MorrisMA/Chameleon/HW/1033-1004_Chameleon-PCBrA.pdf

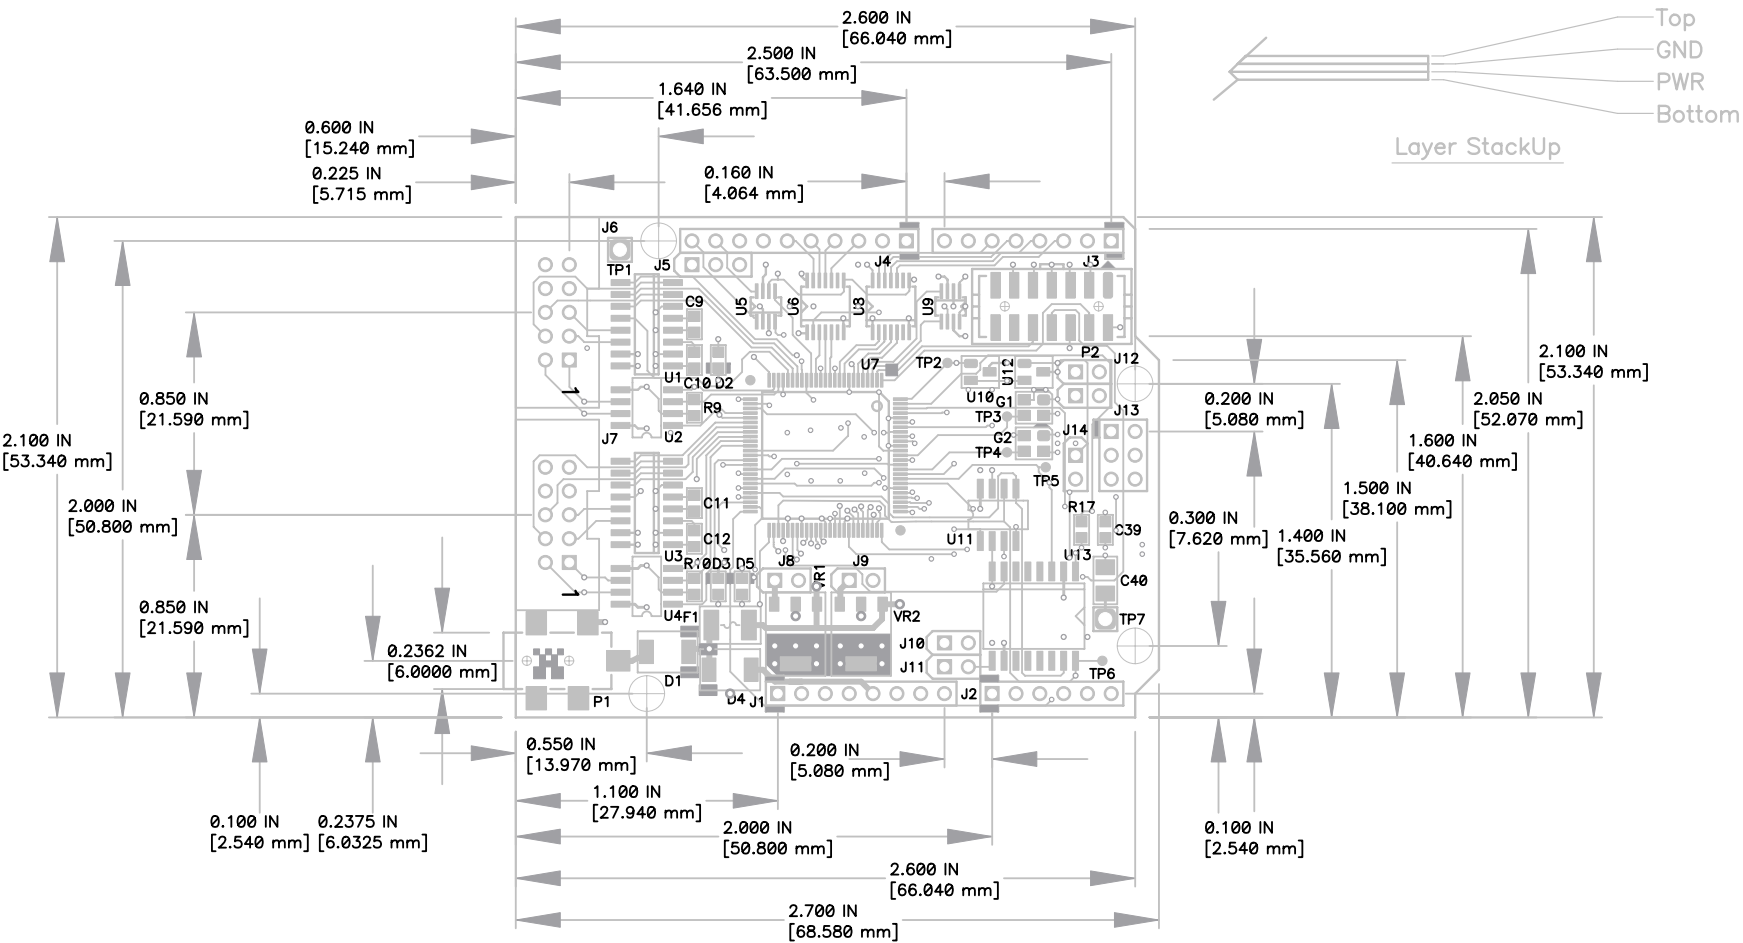
[picture p1: page 1]

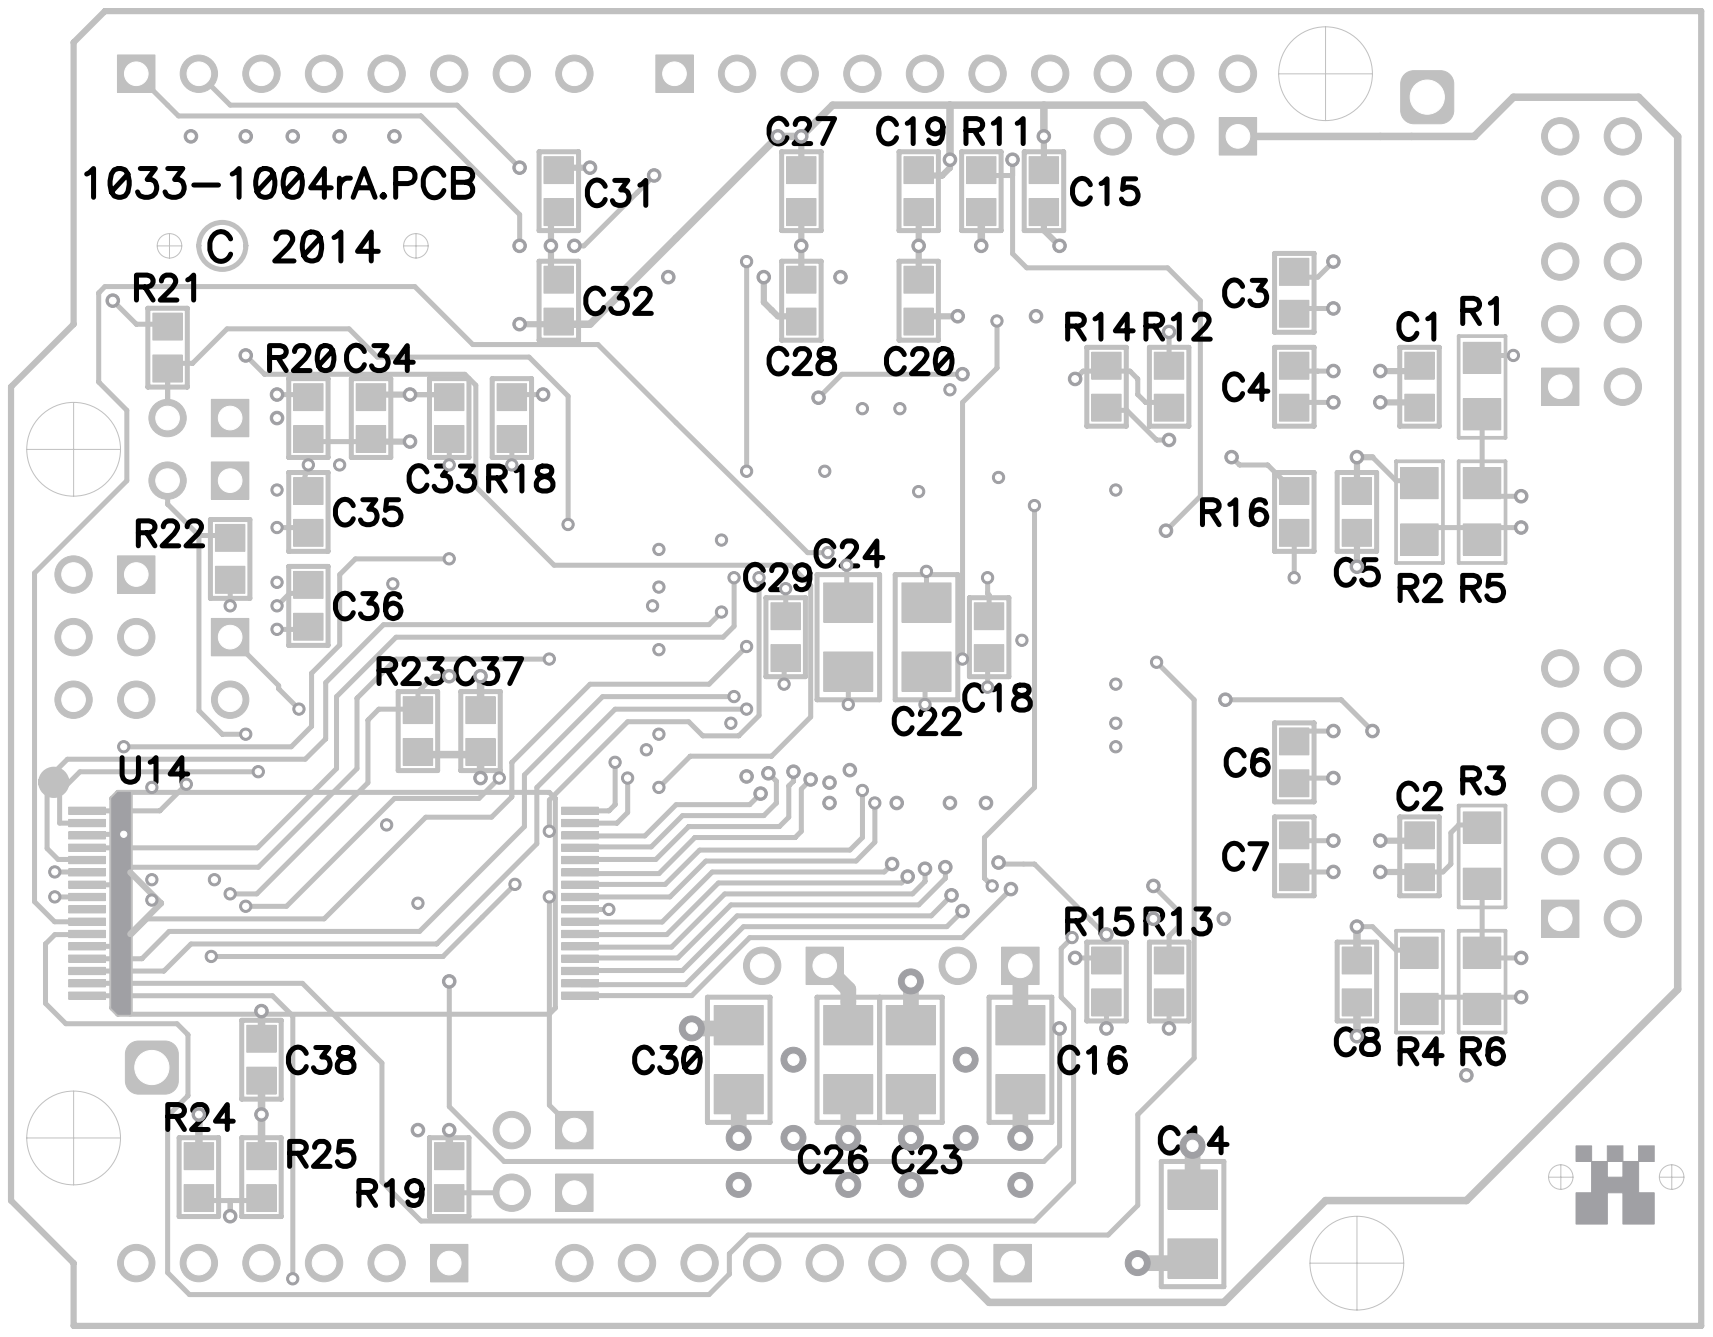
[picture p2: page 2]
