MorrisMA/Chameleon/HW/1033-1004_Chameleon-SCHrA.pdf

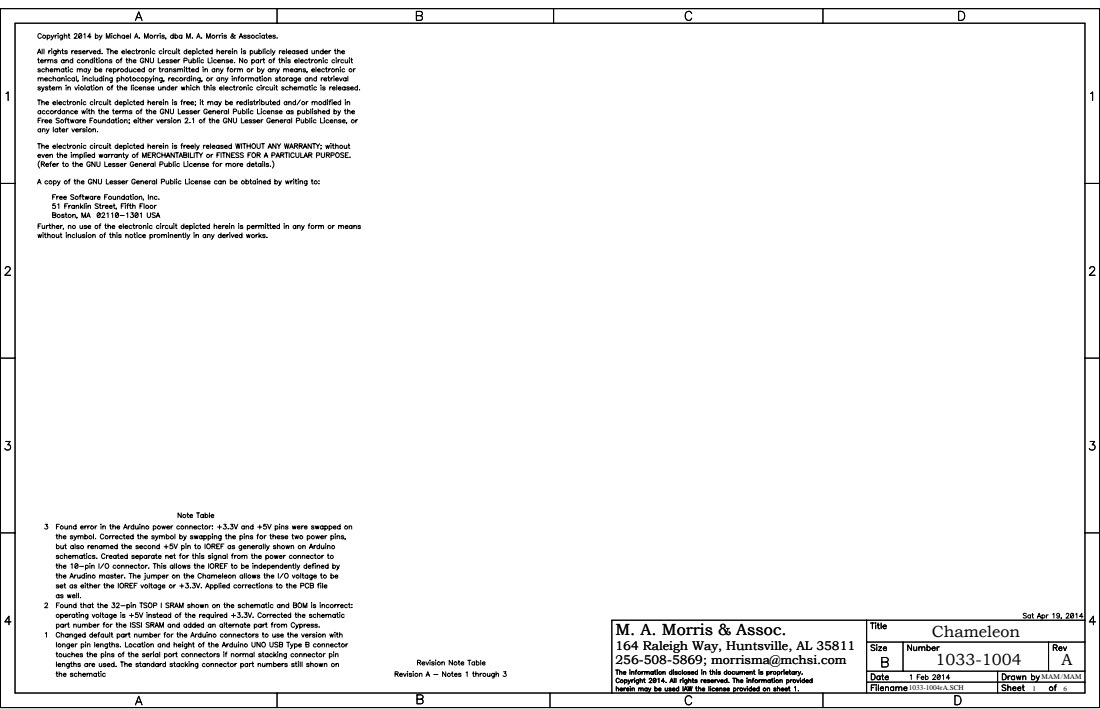
[picture p3: page 1]
MAM; 1033-1004rA.SCH; Chameleon

M. A. Morris & Assoc.
164 Raleigh Way, Huntsville, AL 35811
256-508-5869; morrisma@mchsi.com

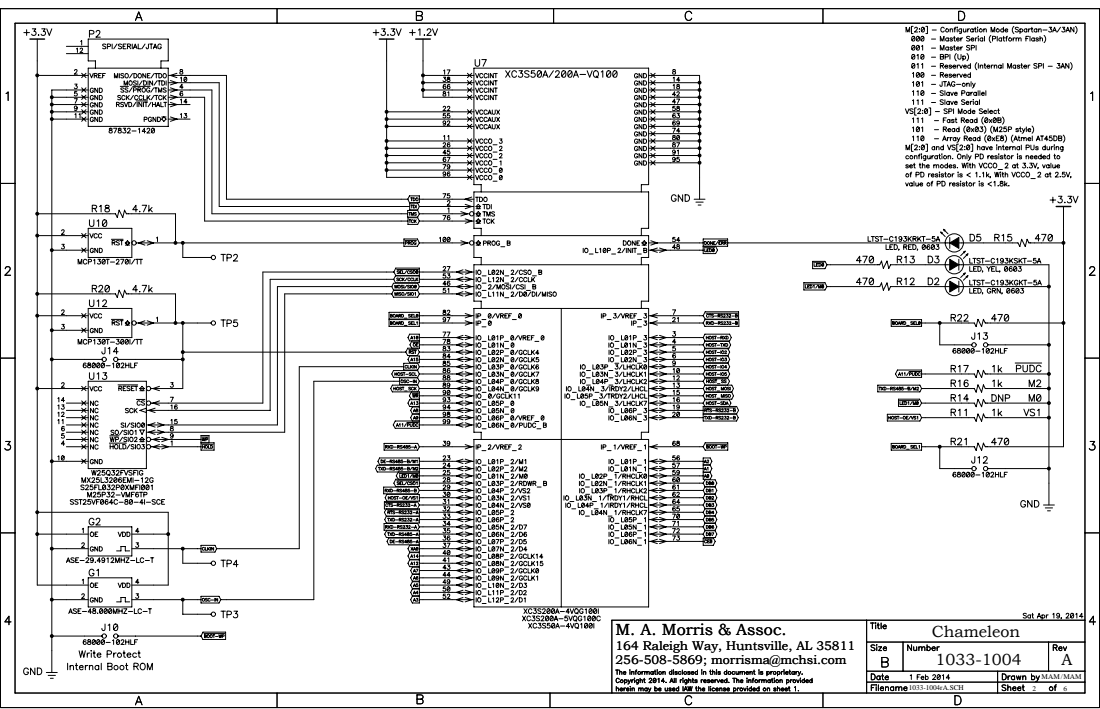
[picture p4: page 2]
Chameleon

M. A. Morris & Assoc.
164 Raleigh Way, Huntsville, AL 35811

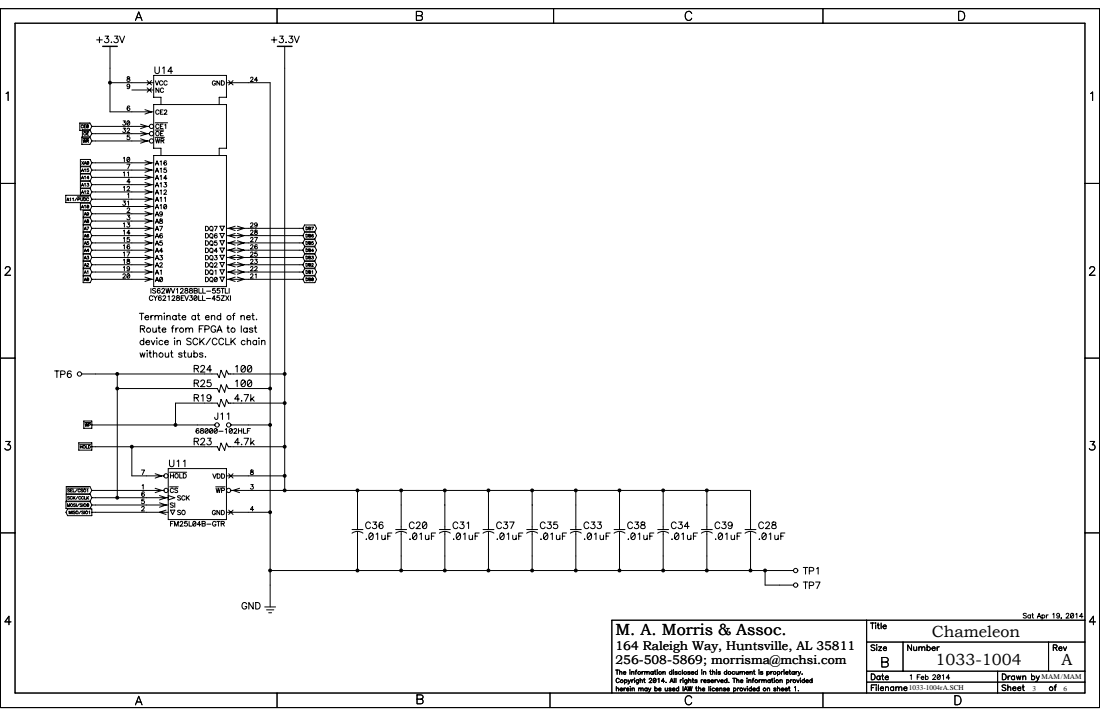
[picture p5: page 3]
Chameleon

M. A. Morris & Assoc.
164 Raleigh Way, Huntsville, AL 35811

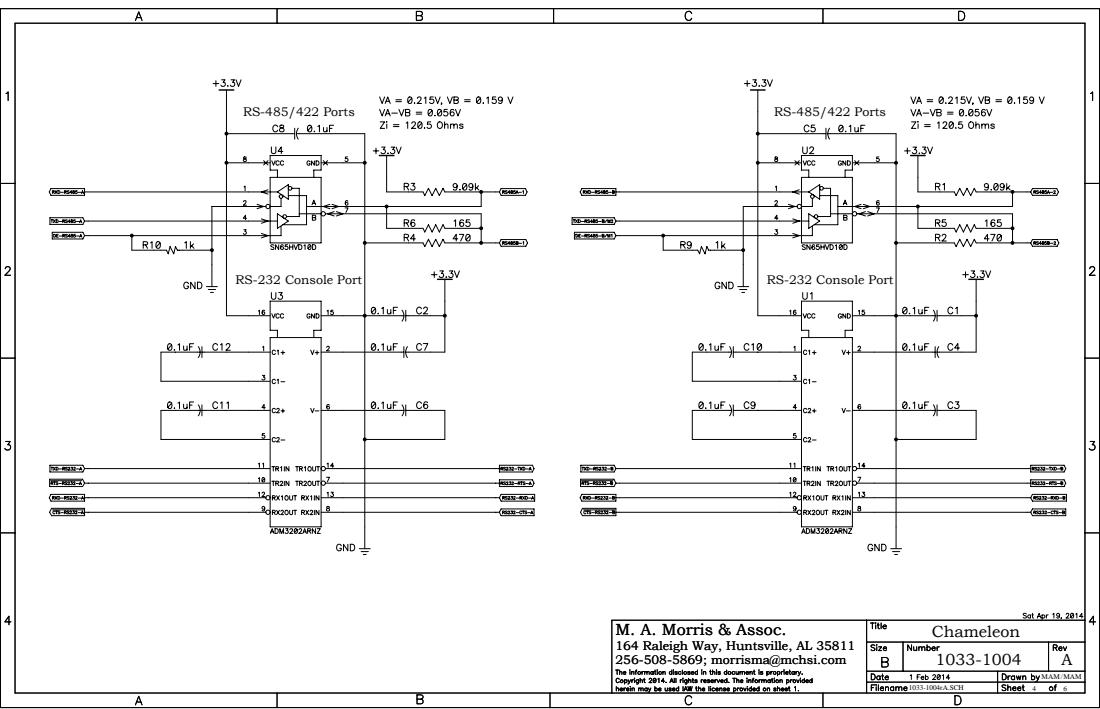
[picture p6: page 4]
RS-485/422 Ports; Chameleon

RS-232 Console Port

M. A. Morris & Assoc.
164 Raleigh Way, Huntsville, AL 35811

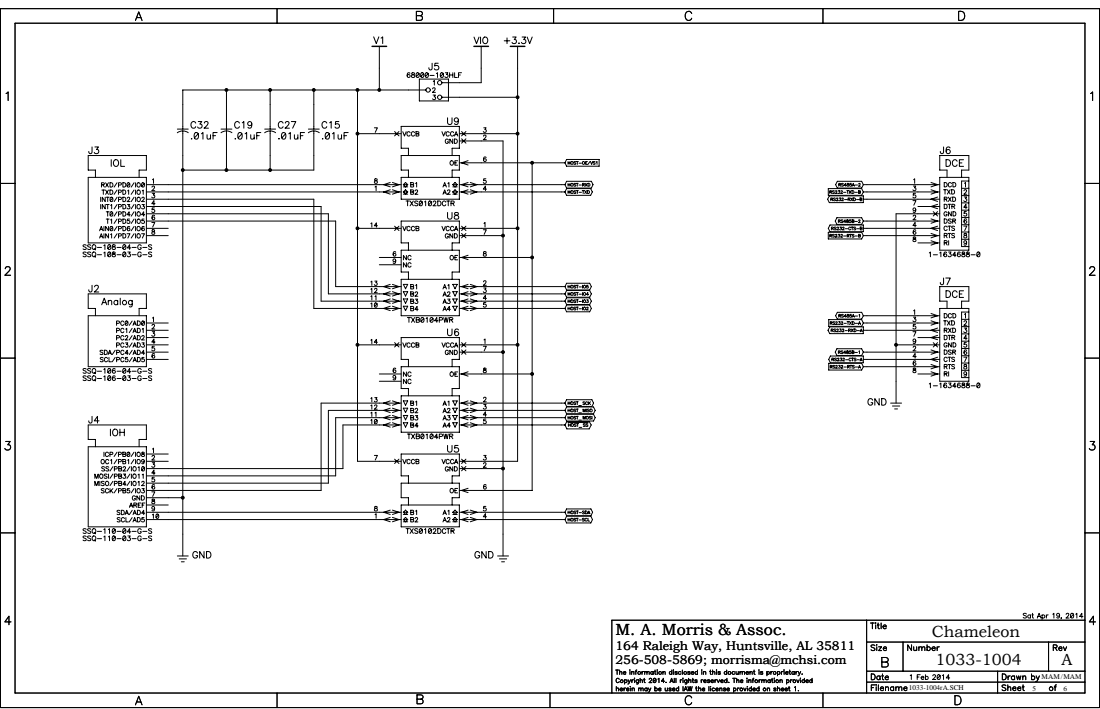
[picture p7: page 5]
Chameleon

M. A. Morris & Assoc.
164 Raleigh Way, Huntsville, AL 35811

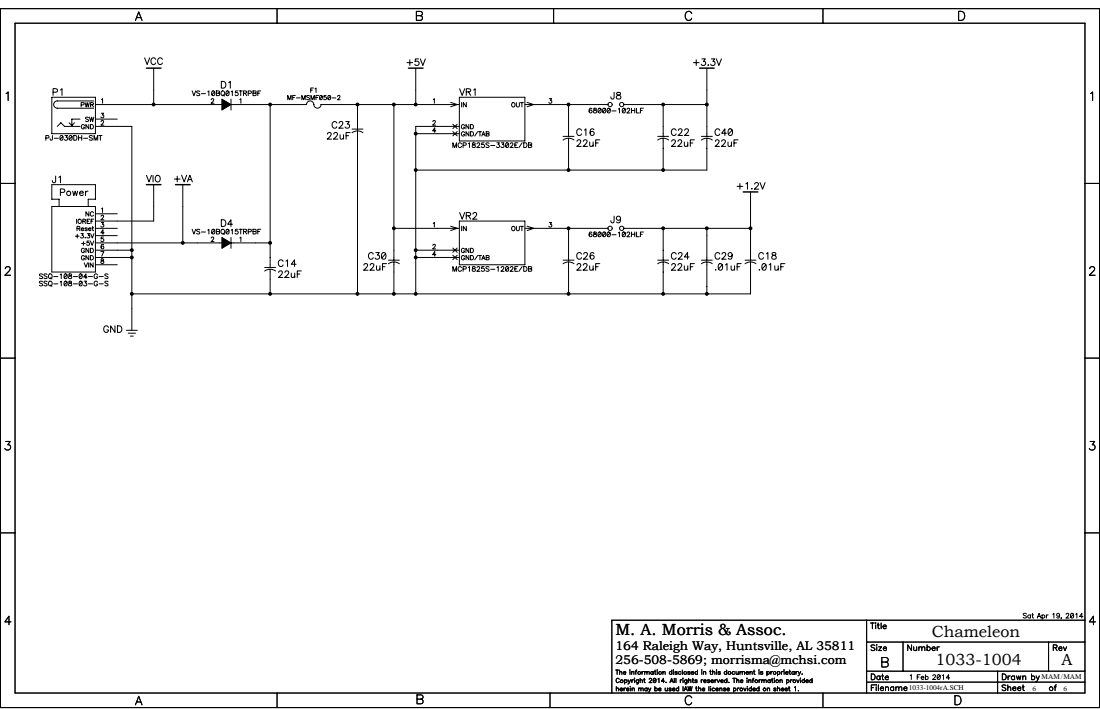
[picture p8: page 6]
Chameleon

M. A. Morris & Assoc.
164 Raleigh Way, Huntsville, AL 35811
