MorrisMA/Chameleon/HW/1033-1004_Chameleon-PCB.pdf

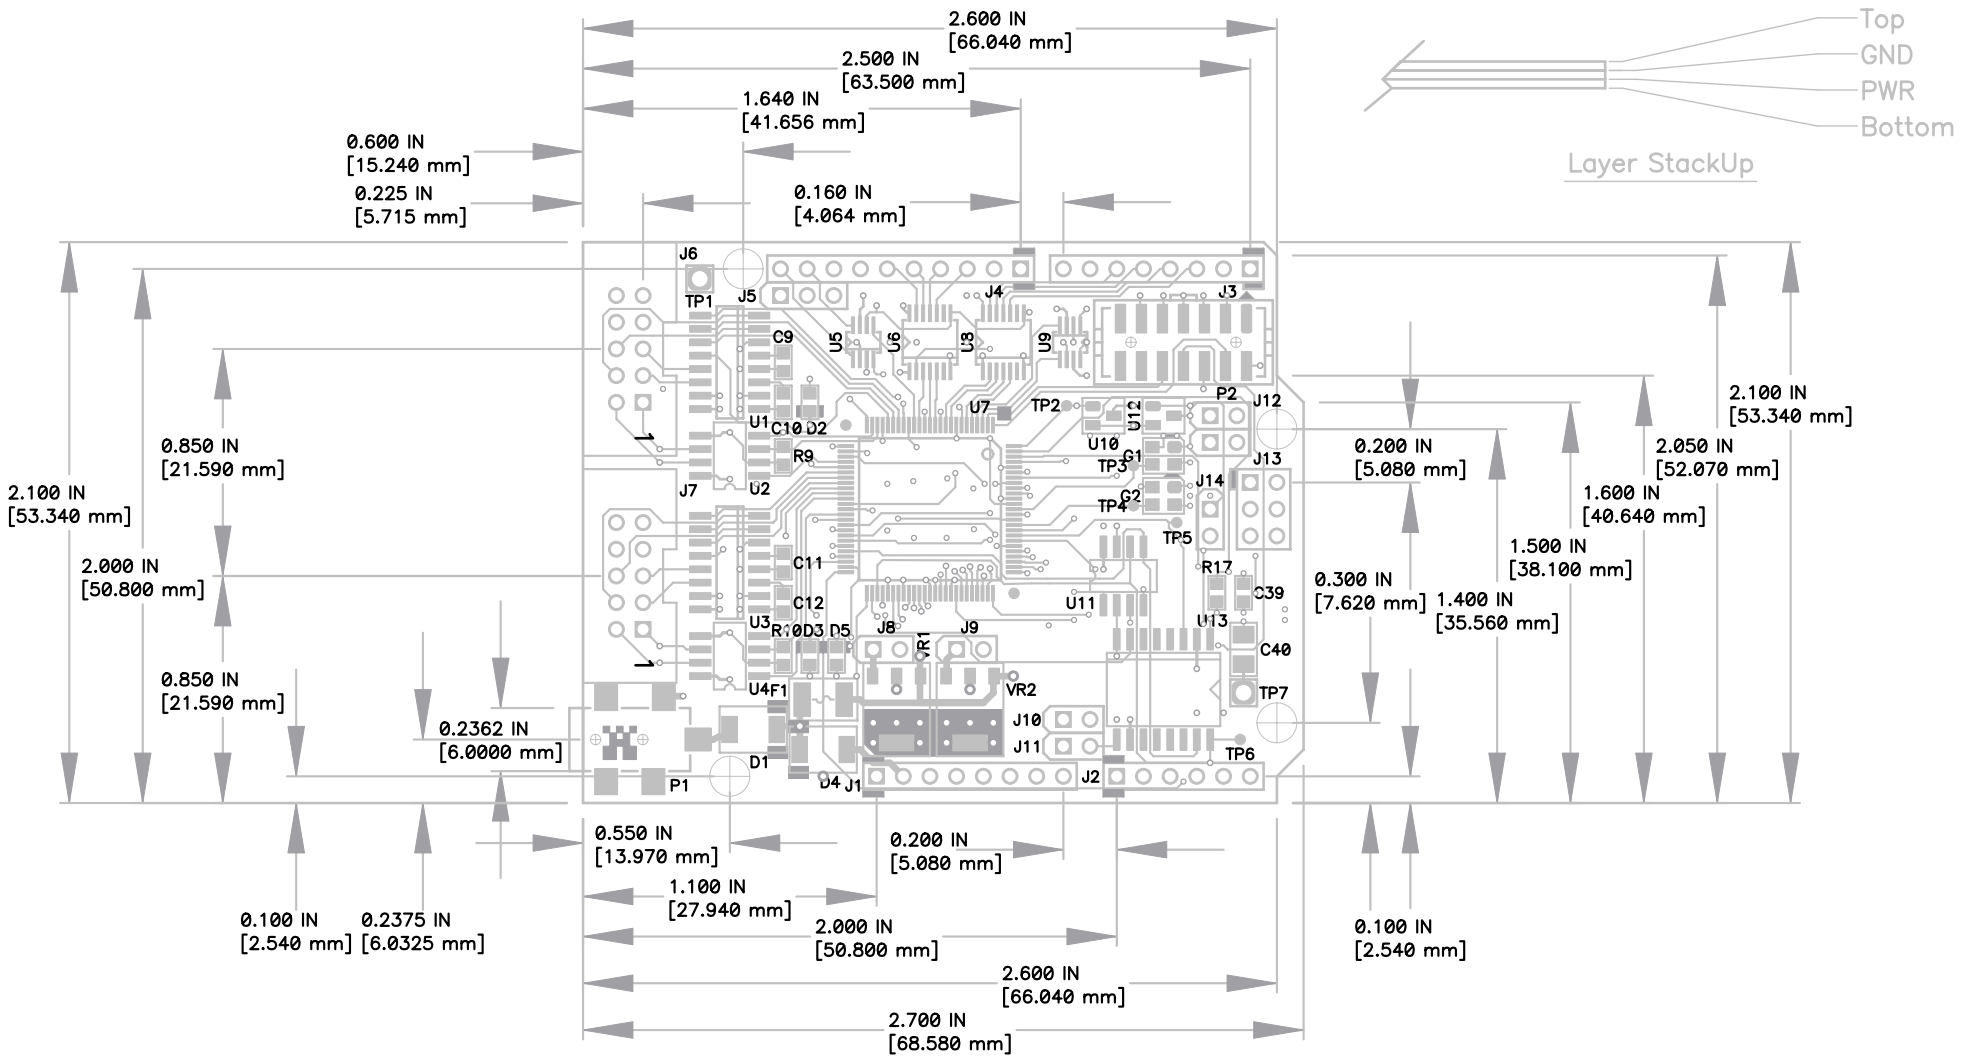
[picture p9: page 1]

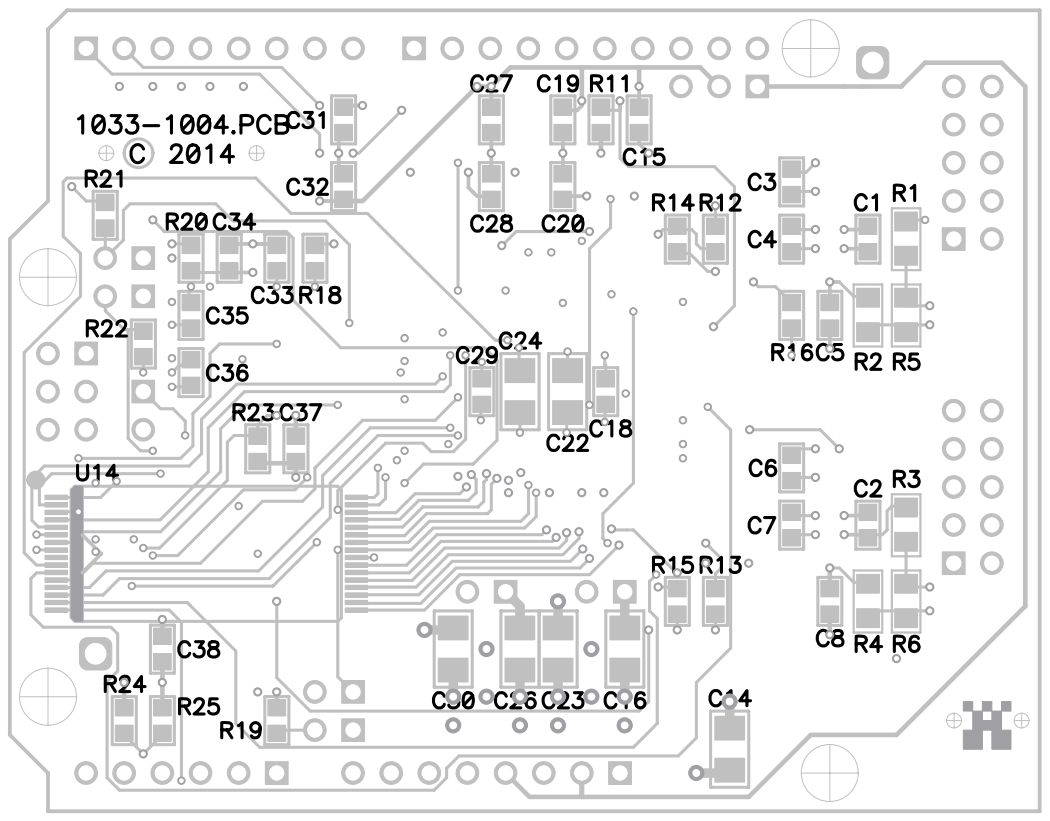
[picture p10: page 2]
