MorrisMA/Chameleon/HW/1033-1004_Chameleon.pdf

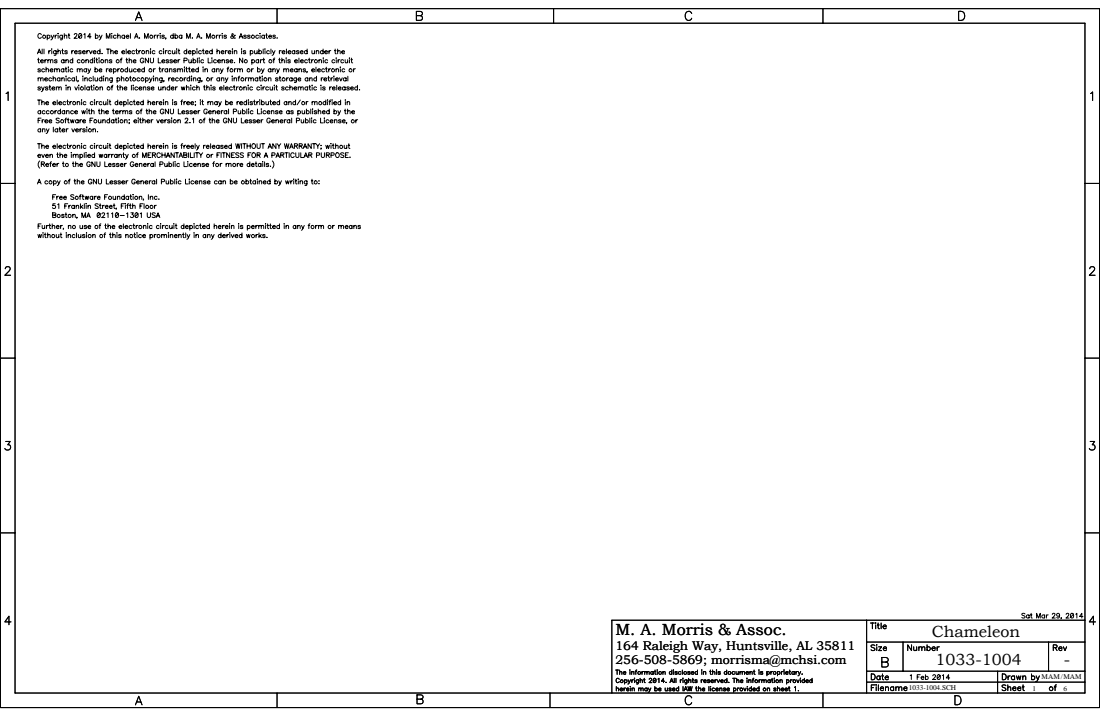
[picture p11: page 1]
1033-1004.SCH; MAM; Chameleon

M. A. Morris & Assoc.
164 Raleigh Way, Huntsville, AL 35811
256-508-5869; morrisma@mchsi.com

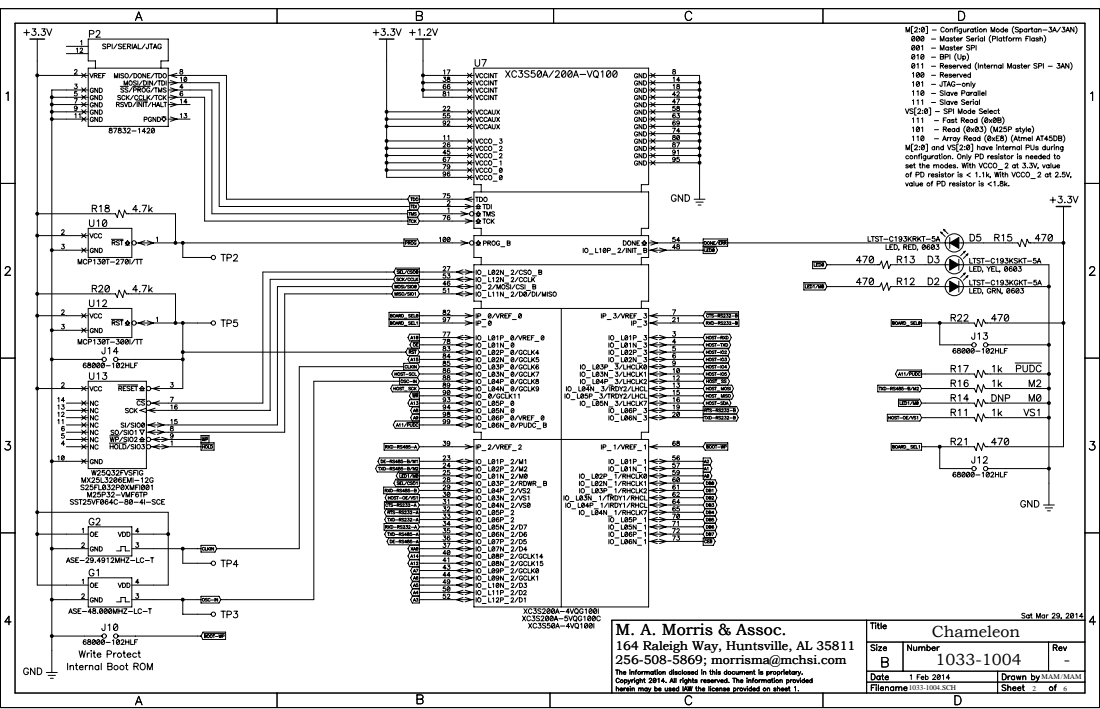
[picture p12: page 2]
Chameleon

M. A. Morris & Assoc.
164 Raleigh Way, Huntsville, AL 35811

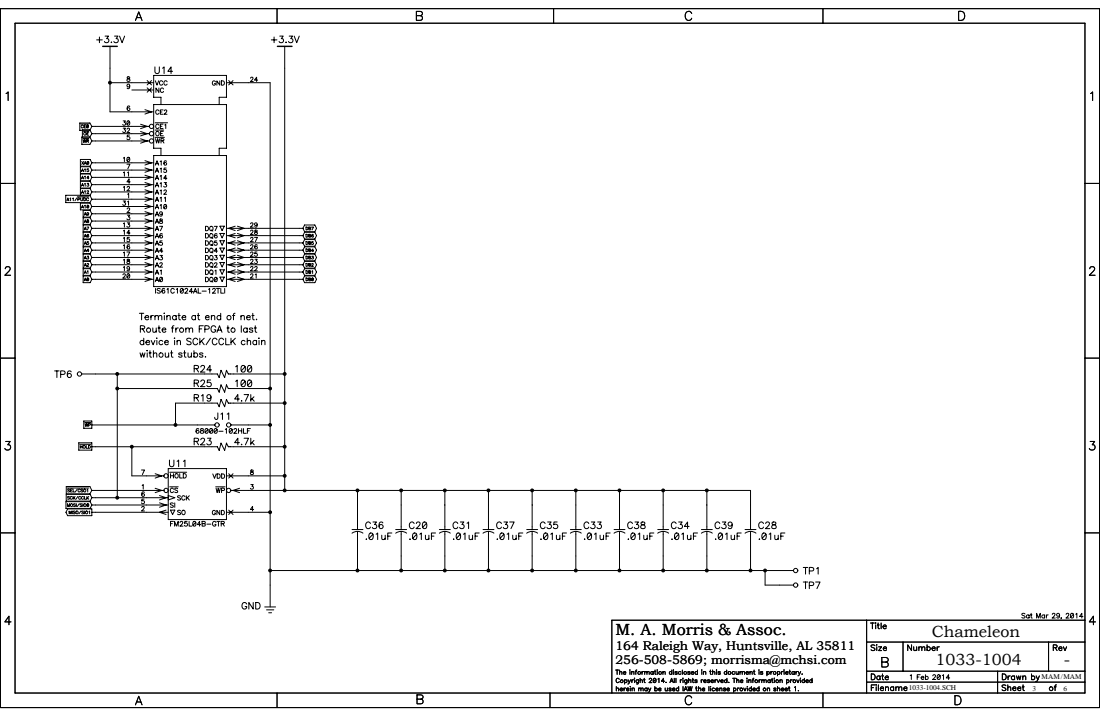
[picture p13: page 3]
Chameleon

M. A. Morris & Assoc.
164 Raleigh Way, Huntsville, AL 35811

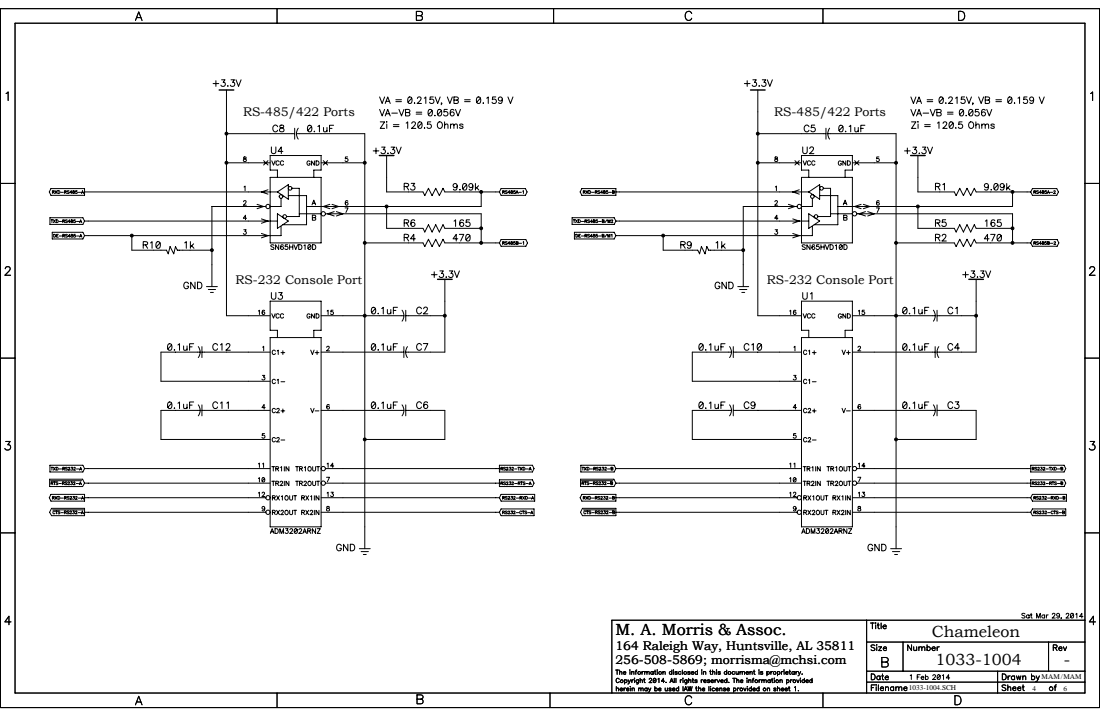
[picture p14: page 4]
RS-485/422 Ports; Chameleon

RS-232 Console Port

M. A. Morris & Assoc.
164 Raleigh Way, Huntsville, AL 35811

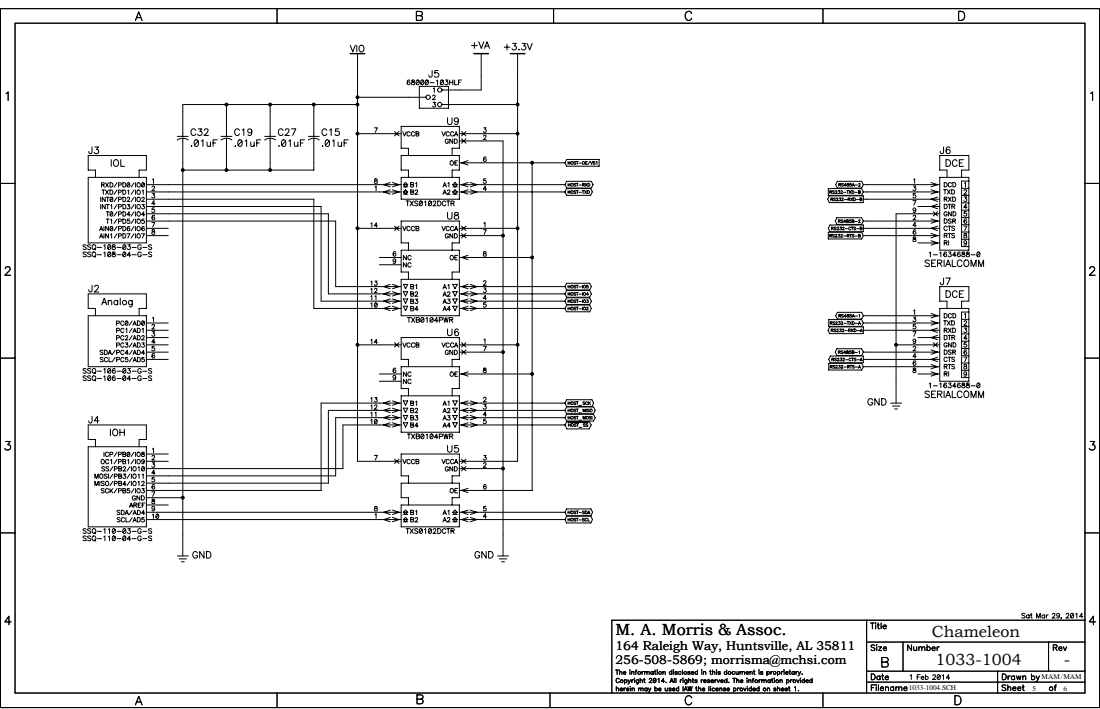
[picture p15: page 5]
Chameleon

M. A. Morris & Assoc.
164 Raleigh Way, Huntsville, AL 35811

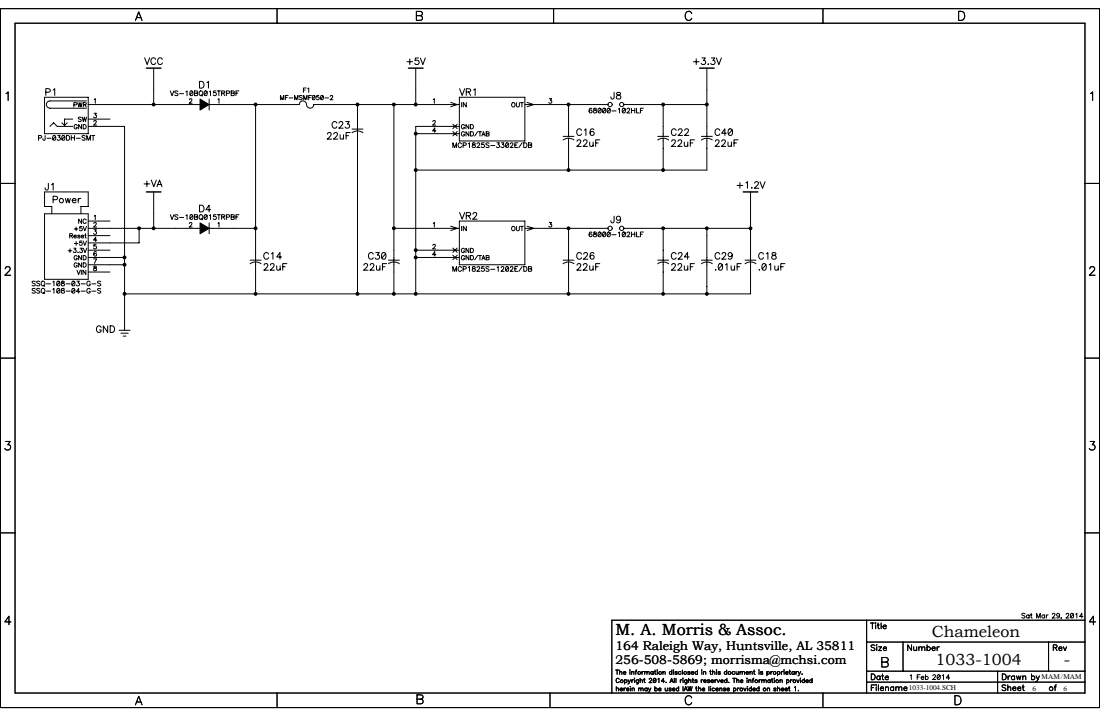
[picture p16: page 6]
Chameleon

M. A. Morris & Assoc.
164 Raleigh Way, Huntsville, AL 35811
