MorrisMA/Chameleon/M65C02_Chameleon/ClkGenV4.v

////////////////////////////////////////////////////////////////////////////////
// Copyright (c) 1995-2008 Xilinx, Inc.  All rights reserved.
////////////////////////////////////////////////////////////////////////////////
//   ____  ____ 
//  /   /\/   / 
// /___/  \  /    Vendor: Xilinx 
// \   \   \/     Version : 10.1.03
//  \   \         Application : xaw2verilog
//  /   /         Filename : ClkGenV4.v
// /___/   /\     Timestamp : 03/28/2014 16:34:08
// \   \  /  \ 
//  \___\/\___\ 
//
//Command: xaw2verilog -st C:\XProjects\ISE10.1i\M65C02_Arduino\Src\\ClkGenV4.xaw C:\XProjects\ISE10.1i\M65C02_Arduino\Src\\ClkGenV4
//Design Name: ClkGenV4
//Device: xc3s200a-4vq100
//
// Module ClkGenV4
// Generated by Xilinx Architecture Wizard
// Written for synthesis tool: XST
`timescale 1ns / 1ps

module ClkGenV4(CLKIN_IN, 
                RST_IN, 
                CLKIN_IBUFG_OUT, 
                CLK0_OUT, 
                CLK2X_OUT, 
                CLK90_OUT, 
                LOCKED_OUT);

    input CLKIN_IN;
    input RST_IN;
   output CLKIN_IBUFG_OUT;
   output CLK0_OUT;
   output CLK2X_OUT;
   output CLK90_OUT;
   output LOCKED_OUT;
   
   wire CLKFB_IN;
   wire CLKIN_IBUFG;
   wire CLK0_BUF;
   wire CLK2X_BUF;
   wire CLK90_BUF;
   wire GND_BIT;
   
   assign GND_BIT = 0;
   assign CLKIN_IBUFG_OUT = CLKIN_IBUFG;
   assign CLK0_OUT = CLKFB_IN;
   IBUFG CLKIN_IBUFG_INST (.I(CLKIN_IN), 
                           .O(CLKIN_IBUFG));
   BUFG CLK0_BUFG_INST (.I(CLK0_BUF), 
                        .O(CLKFB_IN));
   BUFG CLK2X_BUFG_INST (.I(CLK2X_BUF), 
                         .O(CLK2X_OUT));
   BUFG CLK90_BUFG_INST (.I(CLK90_BUF), 
                         .O(CLK90_OUT));
   DCM_SP DCM_SP_INST (.CLKFB(CLKFB_IN), 
                       .CLKIN(CLKIN_IBUFG), 
                       .DSSEN(GND_BIT), 
                       .PSCLK(GND_BIT), 
                       .PSEN(GND_BIT), 
                       .PSINCDEC(GND_BIT), 
                       .RST(RST_IN), 
                       .CLKDV(), 
                       .CLKFX(), 
                       .CLKFX180(), 
                       .CLK0(CLK0_BUF), 
                       .CLK2X(CLK2X_BUF), 
                       .CLK2X180(), 
                       .CLK90(CLK90_BUF), 
                       .CLK180(), 
                       .CLK270(), 
                       .LOCKED(LOCKED_OUT), 
                       .PSDONE(), 
                       .STATUS());
   defparam DCM_SP_INST.CLK_FEEDBACK = "1X";
   defparam DCM_SP_INST.CLKDV_DIVIDE = 2.0;
   defparam DCM_SP_INST.CLKFX_DIVIDE = 1;
   defparam DCM_SP_INST.CLKFX_MULTIPLY = 4;
   defparam DCM_SP_INST.CLKIN_DIVIDE_BY_2 = "FALSE";
   defparam DCM_SP_INST.CLKIN_PERIOD = 20.833;
   defparam DCM_SP_INST.CLKOUT_PHASE_SHIFT = "NONE";
   defparam DCM_SP_INST.DESKEW_ADJUST = "SYSTEM_SYNCHRONOUS";
   defparam DCM_SP_INST.DFS_FREQUENCY_MODE = "LOW";
   defparam DCM_SP_INST.DLL_FREQUENCY_MODE = "LOW";
   defparam DCM_SP_INST.DUTY_CYCLE_CORRECTION = "TRUE";
   defparam DCM_SP_INST.FACTORY_JF = 16'hC080;
   defparam DCM_SP_INST.PHASE_SHIFT = 0;
   defparam DCM_SP_INST.STARTUP_WAIT = "FALSE";
endmodule
