MorrisMA/Chameleon/(commit log)

2014-03-30 Initial creation of the Chameleon Arduino-Compatible FPGA Shield Board repository.
    [PL1033-1004-DKC.xls]
2014-04-19 Updated with current revision. Corrected the power connector pinout, and part numbers of the SRAM and Arduino stacking connectors.
    [BRAM_SP_mn.v, ClkGenV4.v, M65C02_ALU.v, M65C02_ALUv2.v, M65C02_Add.v, M65C02_AddrGen.v]
2014-04-20 Added missing C source file
    [M16C5x.c]
2014-04-26 Converted M16C5x.c program to operate with both UARTs. Found and corrected an error in the SSPx_Slv.v module. Added the SPIxIF, SSPx_Slv, and SSP_UART files. Add another *.HEX file conversion utility.
    [M16C5x.c]
